jonnor/tinyqv-peripheral-pdm-microphone/pico_ice/pico_ice.pcf

# For iceFUN board

set_io --warn-no-port clk    	35
set_io --warn-no-port rst_n    	39

set_io --warn-no-port uio[0]  25	# user_interrupt
set_io --warn-no-port uio[1]  17
set_io --warn-no-port uio[2]  15
set_io --warn-no-port uio[3]  27	# spi_miso
set_io --warn-no-port uio[4]  41	# spi_cs_n
set_io --warn-no-port uio[5]  21	# spi_clk
set_io --warn-no-port uio[6]  19	# spi_mosi
set_io --warn-no-port uio[7]  20

set_io --warn-no-port ui_in[0]  43
set_io --warn-no-port ui_in[1]  38
set_io --warn-no-port ui_in[2]  34
set_io --warn-no-port ui_in[3]  31
set_io --warn-no-port ui_in[4]  42
set_io --warn-no-port ui_in[5]  36
set_io --warn-no-port ui_in[6]  32
set_io --warn-no-port ui_in[7]  28

set_io --warn-no-port uo_out[0] 4
set_io --warn-no-port uo_out[1] 2
set_io --warn-no-port uo_out[2] 47
set_io --warn-no-port uo_out[3] 45
set_io --warn-no-port uo_out[4] 3
set_io --warn-no-port uo_out[5] 48
set_io --warn-no-port uo_out[6] 46
set_io --warn-no-port uo_out[7] 44

set_frequency clk 14
