jonnor/tinyqv-peripheral-pdm-microphone/src/test_harness/falling_edge_detector.sv

/*
 * Copyright (c) 2024 Caio Alonso da Costa
 * SPDX-License-Identifier: Apache-2.0
 */

module falling_edge_detector (rstb, clk, ena, data, neg_edge);

  input logic rstb;
  input logic clk;
  input logic ena;
  input logic data;

  output logic neg_edge;

  logic data_dly;

  always_ff @(negedge(rstb) or posedge(clk)) begin
    if (!rstb) begin
      data_dly <= '0;
    end else begin
      if (ena == 1'b1) begin
        data_dly <= data;
      end
    end
  end

  assign neg_edge = (!data) & data_dly;

endmodule
