jonnor/tinyqv-peripheral-pdm-microphone/scripts/fpga_flash_prog.py

"""
MicroPython script to flash the FPGA on a pico-ice (via RP2040)

MicroPython must already be installed and running on RP2020.

From
https://github.com/MichaelBell/tinyQV/blob/main/pico_ice/micropython/fpga_flash_prog.py 
"""

import time
import machine
from machine import SPI, Pin
machine.freq(133_000_000)

for i in range(30):
    Pin(i, Pin.IN, pull=None)

flash_sel = Pin(17, Pin.IN, Pin.PULL_UP)
ice_creset_b = machine.Pin(27, machine.Pin.OUT)
ice_creset_b.value(0)

spi = SPI(1, 12_000_000, sck=Pin(10), mosi=Pin(11), miso=Pin(8))

flash_sel = Pin(9, Pin.OUT)
ram_sel = Pin(14, Pin.OUT)

flash_sel.on()
ram_sel.off()

# NOTE: Put your filename here 
prog = "fpga_bitstream.bin"
print('Flashing', prog)

def flash_cmd(data, dummy_len=0, read_len=0):
    dummy_buf = bytearray(dummy_len)
    read_buf = bytearray(read_len)
    
    flash_sel.off()
    spi.write(bytearray(data))
    if dummy_len > 0:
        spi.readinto(dummy_buf)
    if read_len > 0:
        spi.readinto(read_buf)
    flash_sel.on()
    
    return read_buf

def flash_cmd2(data, data2):
    flash_sel.off()
    spi.write(bytearray(data))
    spi.write(data2)
    flash_sel.on()

def print_bytes(data):
    for b in data: print("%02x " % (b,), end="")
    print()

CMD_WRITE = 0x02
CMD_READ = 0x03
CMD_READ_SR1 = 0x05
CMD_WEN = 0x06
CMD_SECTOR_ERASE = 0x20
CMD_ID  = 0x90
CMD_RELEASE_POWER_DOWN = 0xAB

# Wake up the flash
flash_cmd([CMD_RELEASE_POWER_DOWN])
time.sleep(1)

id = flash_cmd([CMD_ID], 2, 3)
print_bytes(id)

with open(prog, "rb") as f:
#if False:
    buf = bytearray(4096)
    sector = 0
    while True:
        num_bytes = f.readinto(buf)
        #print_bytes(buf[:512])
        if num_bytes == 0:
            break
        
        flash_cmd([CMD_WEN])
        flash_cmd([CMD_SECTOR_ERASE, sector >> 4, (sector & 0xF) << 4, 0])

        while flash_cmd([CMD_READ_SR1], 0, 1)[0] & 1:
            print("*", end="")
            time.sleep(0.01)
        print(".", end="")

        for i in range(0, num_bytes, 256):
            flash_cmd([CMD_WEN])
            flash_cmd2([CMD_WRITE, sector >> 4, ((sector & 0xF) << 4) + (i >> 8), 0], buf[i:min(i+256, num_bytes)])

            while flash_cmd([CMD_READ_SR1], 0, 1)[0] & 1:
                print("-", end="")
                time.sleep(0.01)
        print(".")
        sector += 1
        
    print("Program done")

with open(prog, "rb") as f:
    data = bytearray(256)
    i = 0
    while True:
        num_bytes = f.readinto(data)
        if num_bytes == 0:
            break
        
        data_from_flash = flash_cmd([CMD_READ, i >> 8, i & 0xFF, 0], 0, num_bytes)
        for j in range(num_bytes):
            if data[j] != data_from_flash[j]:
                raise Exception(f"Error at {i:02x}:{j:02x}: {data[j]} != {data_from_flash[j]}")
        i += 1

print("Verify done")
data_from_flash = flash_cmd([CMD_READ, 0, 0, 0], 0, 16)
print_bytes(data_from_flash)
