jonnor/tinyqv-peripheral-pdm-microphone/(commit log)

2025-07-31 test: Basic checks of PDM clock and interrupt ready
2025-08-03 jam cic3_pdm filter into peripheral
    [cic3_pdm.v, peripheral.v, test.py]
2025-08-04 make: Add a pico target for flashing FPGA bitstream
2025-08-04 scripts: Start of peripheral test via SPI
    Untested, not sure if correct
2025-08-04 src/peripheral: set almost all bits of ctrl at reset
    [peripheral.v]
2025-08-04 override fpga pcf with custom version for pico-ice board
2025-08-04 Fix scripts to actually start the ICE40
    [fpga_flash_prog.py]
2025-08-04 Try improve SPI read
    Not working
2025-08-04 Can read and write over SPI
    Could not use the SPI bus with the special ICE40 pins,
    even after moving away from using the CS of the ICE40 flash
    Instead use one the the SPI options that is on the PMOD itself
    Am able to turn on/off the PDM clock
2025-08-05 scripts/test_peripheral_spi: slowly stream pcm samples
2025-08-08 Revert "src/peripheral: set almost all bits of ctrl at reset"
    This reverts commit 78ccbdf4e57408c0a8511ef325428a6d3cd8106b.
    We got the effect we wanted when testing with FPGA.
    We don't want these ones anymore.
    [peripheral.v]
2025-08-09 src/peripheral: assert interrupt on conversion, clear on read
2025-08-10 scripts: Try to make PCM reading fast
    Runs project at 64 Mhz, SPI clock at 6 Mhz
    Can read each sample at 32 us, when reading 100
    Deadline at 16 kHz is 62.5 us
2025-08-10 scripts: Read PCM with interrupts and ringbuffer
    With RPI at 200 Mhz, it looks like we can read 10-11khz rate
    However reading gets stuck after some 10-40 samples,
    the interrupt stops triggering - possibly because a read was missed
    Doing a read again unblocks the situation (for a short while)
2025-08-11 test/test: skip checking interrupt
    [test.py]
2025-08-11 Initialize PCM sample on reset
    [peripheral.v]
2025-08-12 Use wire for pcm_valid
    Does not seem that it needs to be registered,
    and avoids needing to initialize
    [peripheral.v]
2025-08-12 Try prevent pdm_int from being removed in synthesis
    [peripheral.v]
2025-08-12 cic3_pdm: Trigger initialization on posedge rst
    Otherwise we had the problem that all registers were left uninitialized,
    because the pdm/filter clock is not started until later
    [cic3_pdm.v]
2025-09-05 src/peripheral: select input pin with pdm_select register
2025-09-05 src/peripheral: reset interrupt on any size read of sample
    [peripheral.v]
2025-09-10 Move SPI test script to ttsky25a-pdm-microphone
